UnQuaiz/GoPro-ardu-bacpac/MewPro/README.md

# MewPro  

Arduino BacPac™ for GoPro Hero 3+ Black: GoPro can be controlled by Arduino Pro Mini attached on Herobus.

Resources:
* Introduction to MewPro: (https://mewpro.cc/en/2014/10/21/how-to-use-mewpro-and-its-application/)
* Schematic Drawing: **[PDF](MewPro-ver1.1.pdf) | [Eagle](MewPro-ver1.1.sch)**
* [Herobus Pinout of GoPro Hero 3+ Black](HeroBus+Pinouts.md)
* [List of GoPro Serial Commands](list-of-i2c-commands.md)

_Saved from origin : https://github.com/orangkucing/MewPro_
