UnQuaiz/GoPro-ardu-bacpac/GoPro3-video-out-cable/GoPro3FPVcable21.jpg

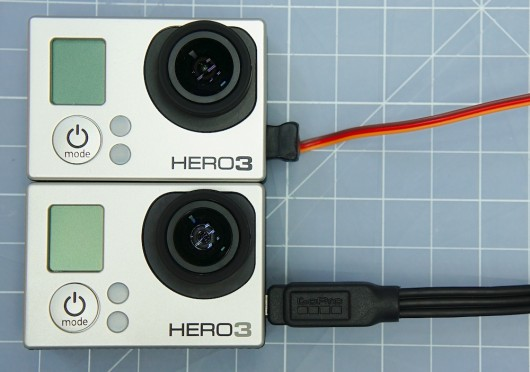
GoPro3-video-out-cable/GoPro3FPVcable21.jpg
