UnQuaiz/GoPro-ardu-bacpac/MewPro/MewPro-ver1.1.pdf

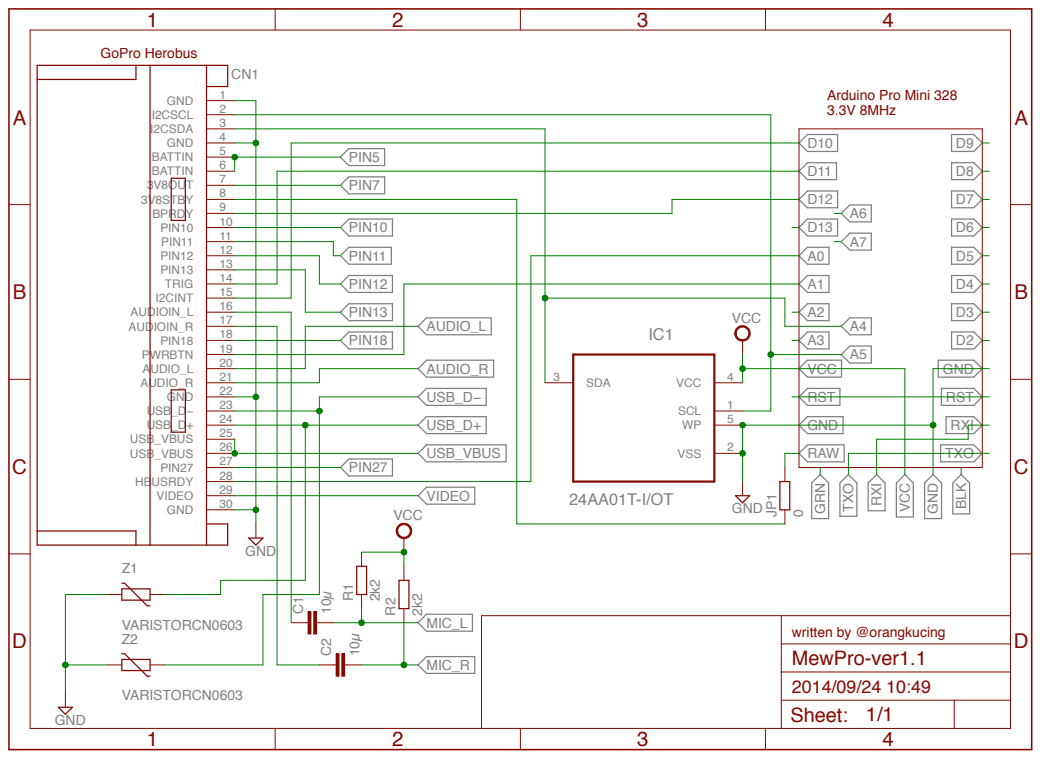
[picture p18: page 1]
